millerlp/MusselGapeTracker_hardware/Pictures/Hall_effect_wiring_labeled.png

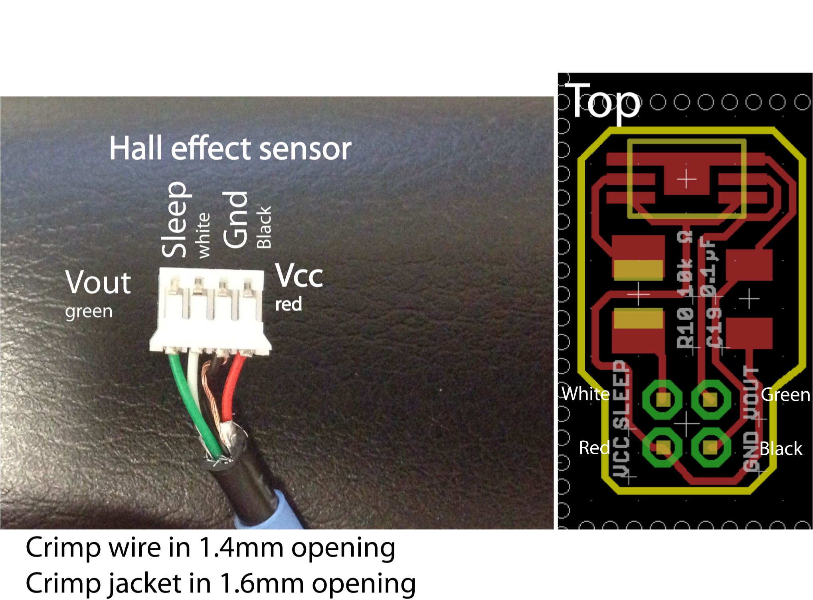
Pictures/Hall_effect_wiring_labeled.png
