millerlp/MusselGapeTracker_hardware/Pictures/RevA_2017-06-27 14.04.41.jpg

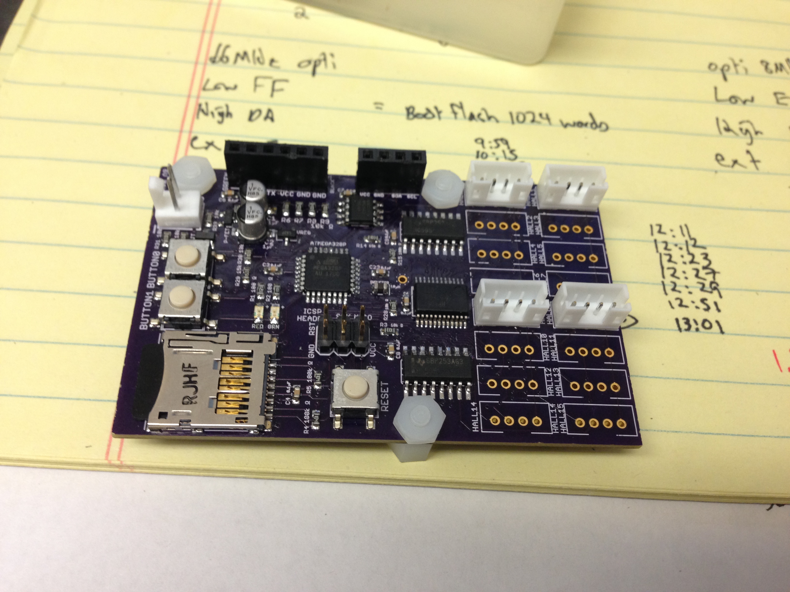
Pictures/RevA_2017-06-27 14.04.41.jpg
