millerlp/MusselGapeTracker_hardware/README.md

# MusselGapeTracker_hardware
 Mussel Gape Tracker circuit board designs
