millerlp/MusselGapeTracker_hardware/datasheets/atmega328_qtfp.jpg

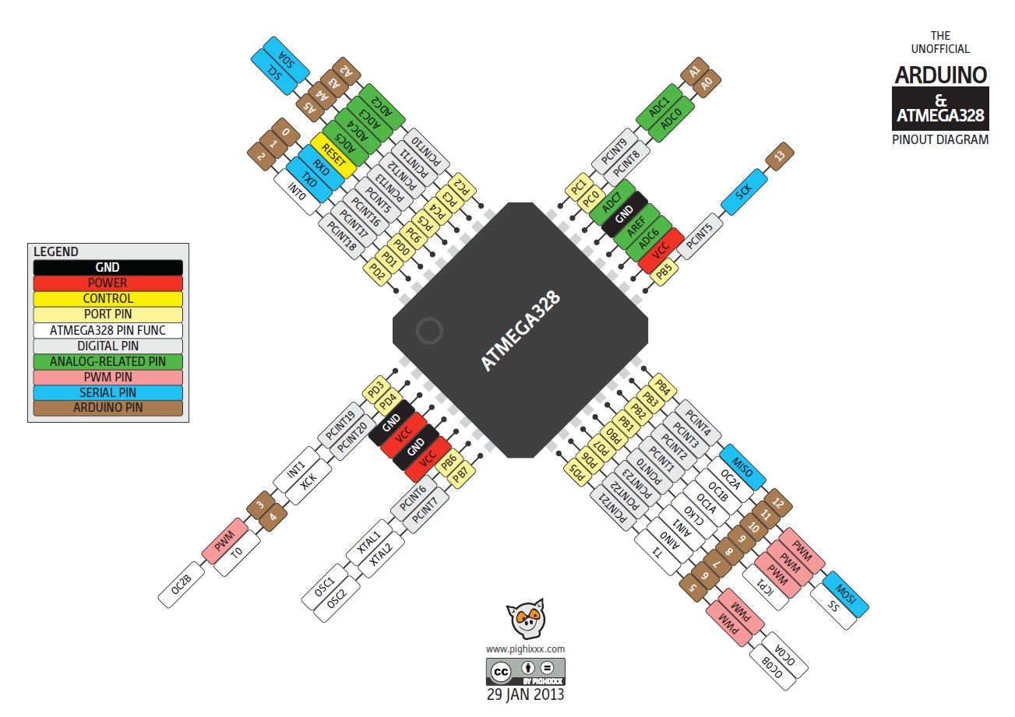
datasheets/atmega328_qtfp.jpg
