millerlp/MusselGapeTracker_hardware/datasheets/CD74HC4067_mux_pinout.png

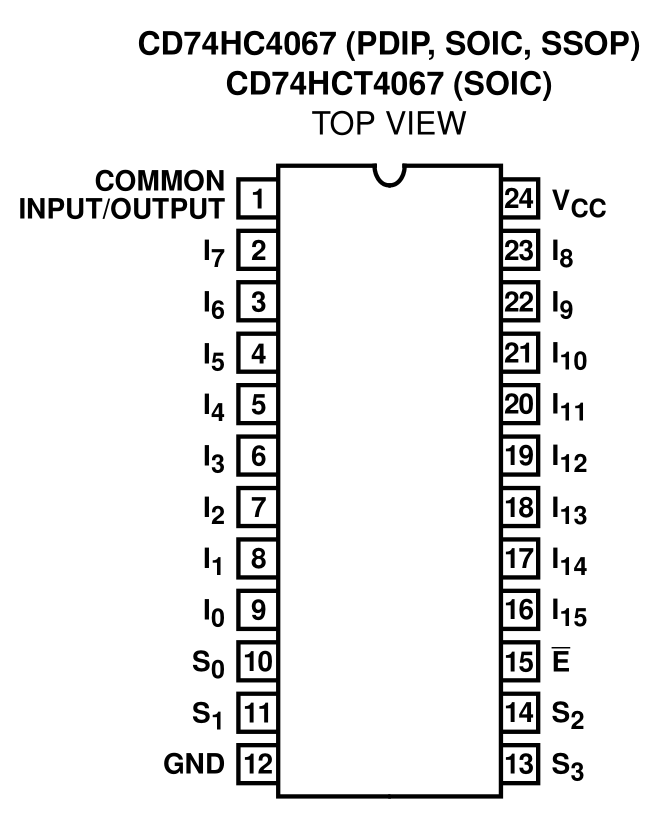
datasheets/CD74HC4067_mux_pinout.png
