millerlp/MusselGapeTracker_hardware/datasheets/Gammon_forum_74HC595_schematic.png

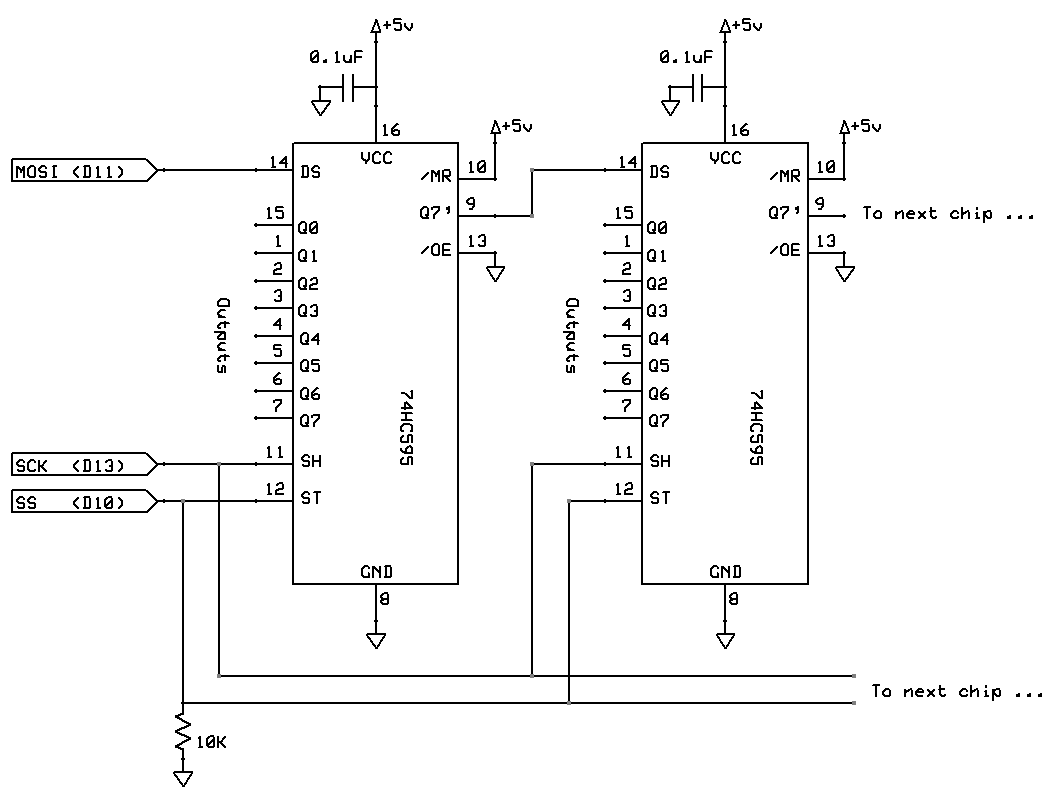
datasheets/Gammon_forum_74HC595_schematic.png
