millerlp/MusselGapeTracker_hardware/datasheets/SN74HC595D_pinout.png

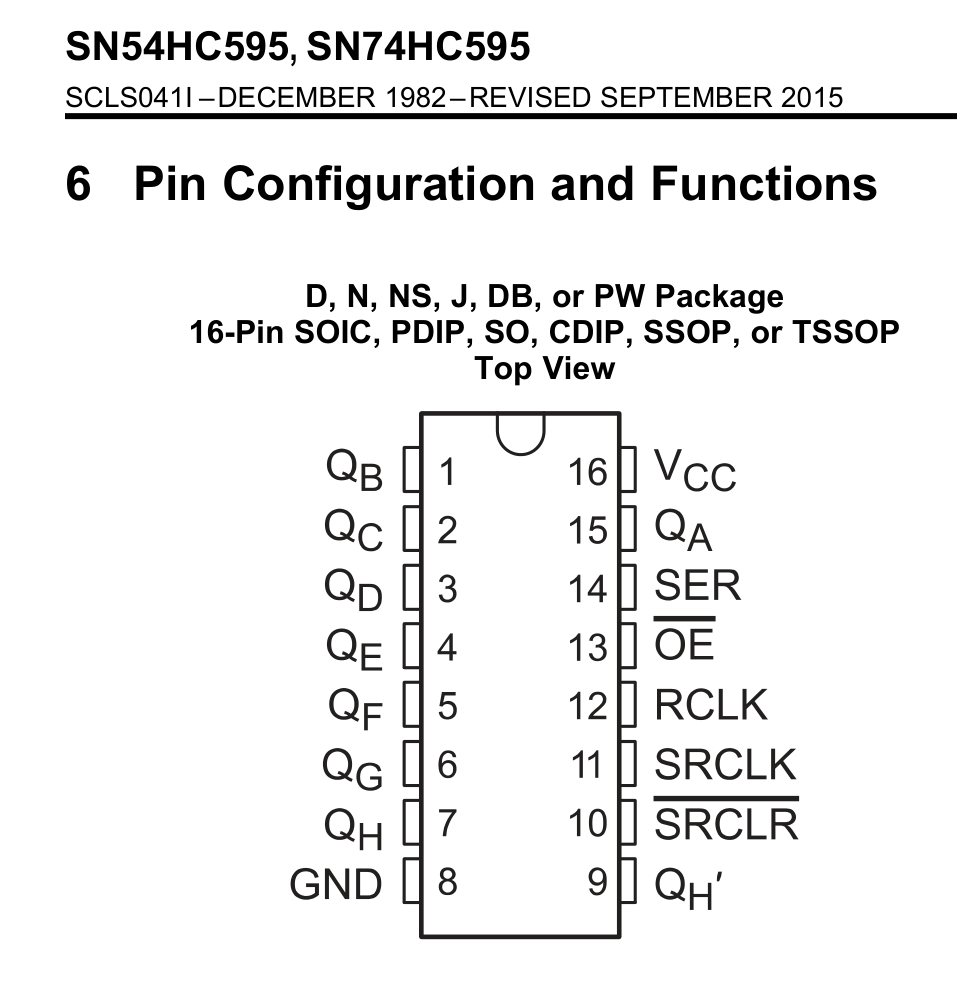
datasheets/SN74HC595D_pinout.png
