millerlp/MusselGapeTracker_hardware/Pictures/2019-05-07 10.28.47.jpg

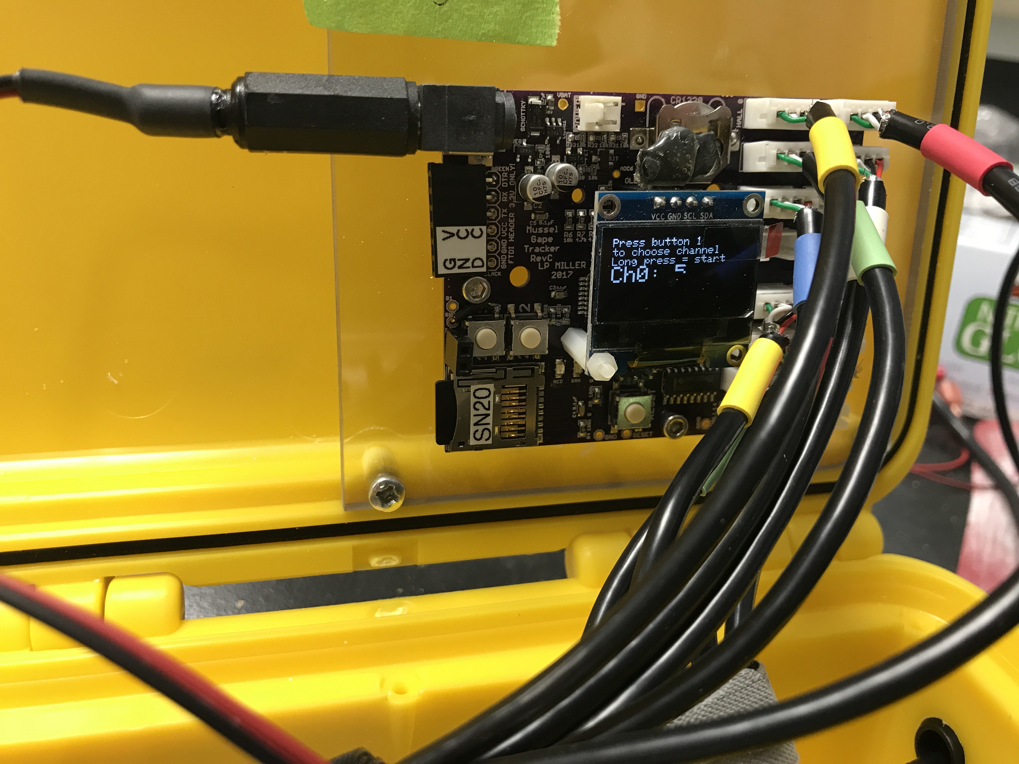
Pictures/2019-05-07 10.28.47.jpg
