millerlp/MusselGapeTracker_hardware/Pictures/2019-05-07 10.29.05.jpg

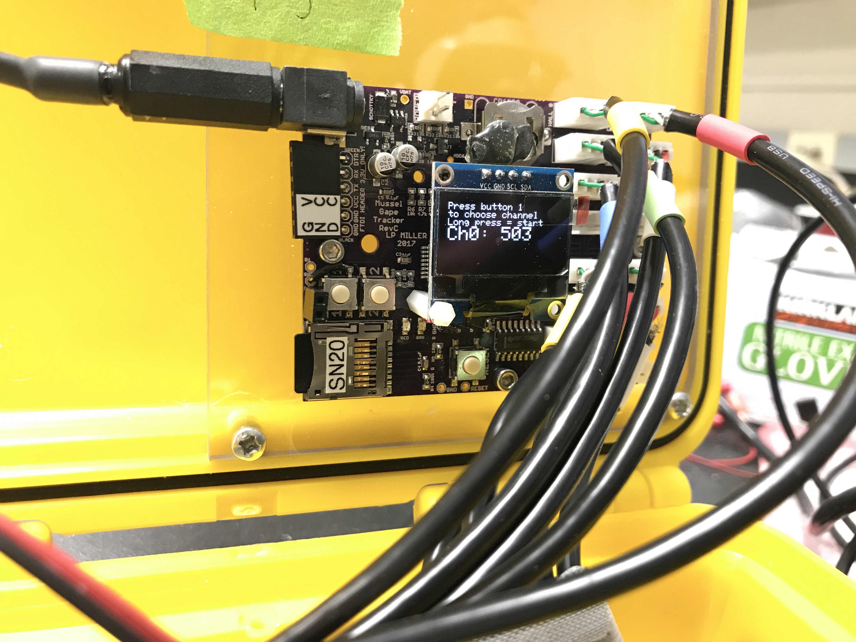
Pictures/2019-05-07 10.29.05.jpg
