millerlp/MusselGapeTracker_hardware/Pictures/Power_management_schematic.png

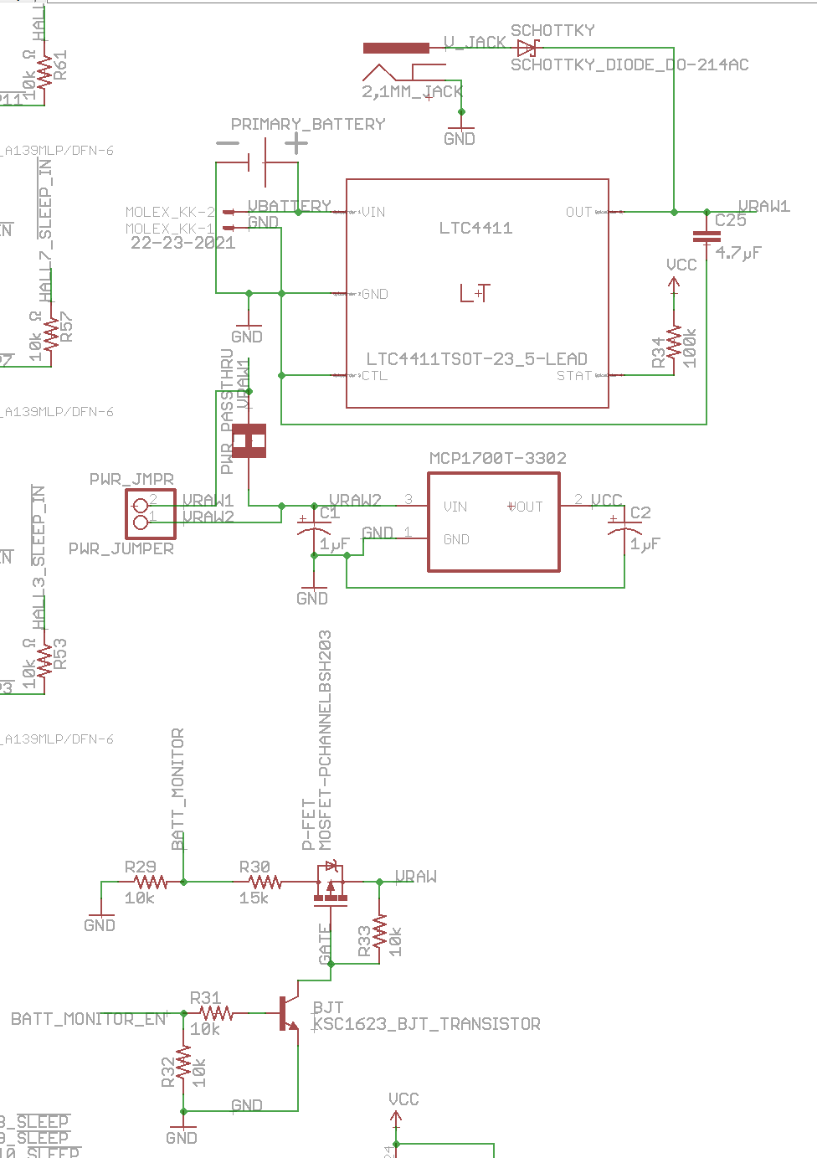
Pictures/Power_management_schematic.png
