millerlp/MusselGapeTracker_hardware/KiCad_files/Hall_effect_sensor_board_A139x/Hall_effect_sensor_board_A139x_parts_list.xlsx

Part Description | Manufacturer | Mfr. PN | Quantity (for 1 board) | Digikey PN | Digikey $ | Extended $ | Notes | Alt. Manu PN | Alt. Digikey PN
Hall effect sensor, Allegro A1395 | Allegro | A1395SEHLT-T | 1 | 620-1173-6-ND | $2.00 | $2.00 | Can also substitute A1393 or A1391 models, but these are less sensitive
Resistor, 0603 size 10k ohm 1/10Watt | Yageo | RC0603JR-0710KL | 1 | 311-10KGRCT-ND | $0.10 | $0.10 | Any 10k ohm, 1/10Watt, 5% tolerance, size 0603 resistor will work here | RMCF0603JT10K0 | RMCF0603JT10K0TR-ND
Capacitor, 0603 0.1µF 16V ceramic | KEMET | C0603C104K4RACTU | 1 | 399-1096-1-ND | $0.10 | $0.10 | Any 0.1uF 16V ceramic capacitor, size 0603 will work here | CC0603KRX7R7BB104 | 311-1088-2-ND
Additional parts - optional
Magnet 0.25"diam x 0.063" thick | Radial Magnet Inc | 8195 | 1 | 469-1005-ND | $0.23 | $0.23 | This is the typical magnet we use, but any decent magnet should work
4-conductor cable USB-2.0 28gauge 0.150" diameter | CNC Tech | 2725-2828-BL-01000-A | 1 | CN230-B-100-ND |  |  | 100 foot spool
JST 4-pin connector housing, female | JST Sales | PHR-4 | 1 | 455-1164-ND | $0.10 | $0.10
JST crimp-on female connector 24-30AWG | JST Sales | SPH-002T-P0.5S | 4 | 455-1127-1-ND | $0.10 | $0.40 | Always buy several extra
Heat shrink 1/4" ID x 4ft - moisture proof adhesive lined, semi-rigid | TE Connectivity | SCL-1/4-0-STK | 1 | SCL-1/4-0-STK-ND |  |  | Use approx 1.5" per sensor, can be either 1/4" or 0.3" inside diameter
Heat shrink 0.3" ID x 4ft - moisture proof adhesive lined, semi-rigid | TE Connectivity | SST-48-03/FR/97 | 1 | SST-48-03/FR/97-ND |  |  | Use approx 1.5" per sensor, can be either 1/4" or 0.3" inside diameter
