millerlp/MusselGapeTracker_hardware/deprecated/MusselGapeTracker_RevA_2_bom.txt

Partlist exported from D:/Dropbox/Eagle/Eagle_projects/MusselGapeTracker/MusselGapeTracker_RevA_2.sch at 5/26/2017 2:39 PM

Part           Value                             Device                            Package                           Description                                                                                                                      MF    MPN               OC_FARNELL OC_NEWARK PACKAGE PROD_ID     SUPPLIER  VALUE     
A139_HALL0     HALL_EFFECT_ALLEGRO_A139MLP/DFN-6 HALL_EFFECT_ALLEGRO_A139MLP/DFN-6 A139*_HALL_EFFECT                 Allegro A139* series Hall effect sensors                                                                                                                                                                              
A139_HALL1     HALL_EFFECT_ALLEGRO_A139MLP/DFN-6 HALL_EFFECT_ALLEGRO_A139MLP/DFN-6 A139*_HALL_EFFECT                 Allegro A139* series Hall effect sensors                                                                                                                                                                              
A139_HALL2     HALL_EFFECT_ALLEGRO_A139MLP/DFN-6 HALL_EFFECT_ALLEGRO_A139MLP/DFN-6 A139*_HALL_EFFECT                 Allegro A139* series Hall effect sensors                                                                                                                                                                              
A139_HALL3     HALL_EFFECT_ALLEGRO_A139MLP/DFN-6 HALL_EFFECT_ALLEGRO_A139MLP/DFN-6 A139*_HALL_EFFECT                 Allegro A139* series Hall effect sensors                                                                                                                                                                              
A139_HALL4     HALL_EFFECT_ALLEGRO_A139MLP/DFN-6 HALL_EFFECT_ALLEGRO_A139MLP/DFN-6 A139*_HALL_EFFECT                 Allegro A139* series Hall effect sensors                                                                                                                                                                              
A139_HALL5     HALL_EFFECT_ALLEGRO_A139MLP/DFN-6 HALL_EFFECT_ALLEGRO_A139MLP/DFN-6 A139*_HALL_EFFECT                 Allegro A139* series Hall effect sensors                                                                                                                                                                              
A139_HALL6     HALL_EFFECT_ALLEGRO_A139MLP/DFN-6 HALL_EFFECT_ALLEGRO_A139MLP/DFN-6 A139*_HALL_EFFECT                 Allegro A139* series Hall effect sensors                                                                                                                                                                              
A139_HALL7     HALL_EFFECT_ALLEGRO_A139MLP/DFN-6 HALL_EFFECT_ALLEGRO_A139MLP/DFN-6 A139*_HALL_EFFECT                 Allegro A139* series Hall effect sensors                                                                                                                                                                              
A139_HALL8     HALL_EFFECT_ALLEGRO_A139MLP/DFN-6 HALL_EFFECT_ALLEGRO_A139MLP/DFN-6 A139*_HALL_EFFECT                 Allegro A139* series Hall effect sensors                                                                                                                                                                              
A139_HALL9     HALL_EFFECT_ALLEGRO_A139MLP/DFN-6 HALL_EFFECT_ALLEGRO_A139MLP/DFN-6 A139*_HALL_EFFECT                 Allegro A139* series Hall effect sensors                                                                                                                                                                              
A139_HALL10    HALL_EFFECT_ALLEGRO_A139MLP/DFN-6 HALL_EFFECT_ALLEGRO_A139MLP/DFN-6 A139*_HALL_EFFECT                 Allegro A139* series Hall effect sensors                                                                                                                                                                              
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
C32            0.1µF                             CAP0603                           0603                              Capacitor                                                                                                                                                                                                             
C33            0.1µF                             CAP0603                           0603                              Capacitor                                                                                                                                                                                                             
CR1220_BATTERY CR1220_BATTERY_HOLDERSMD          CR1220_BATTERY_HOLDERSMD          CR1220_BATTERY_HOLDER_SMD         CR1220 Battery Holder                                                                                                                                                                                                 
DS3231M        DS3231MSOIC-8                     DS3231MSOIC-8                     DS3231M_SOIC8                     DS3231M real time clock                                                                                                                                                                                               
GROUND_CON     SOLDER_JUMPER_TRACESTANDARD       SOLDER_JUMPER_TRACESTANDARD       SJ_2S-TRACE                       Solder jumper with trace                                                                                                                                                                                              
HALL0          JST-4PINTH_STRAIGHT               JST-4PINTH_STRAIGHT               JST-PH-4-THM                      JST PH series male header pins                                                                                                                                                                                        
HALL0_HEADER   PINHD-2X21.5MM_SILK               PINHD-2X21.5MM_SILK               2X2_1.5MM                         2x2 header                                                                                                                                                                                                            
HALL1          JST-4PINTH_STRAIGHT               JST-4PINTH_STRAIGHT               JST-PH-4-THM                      JST PH series male header pins                                                                                                                                                                                        
HALL1_HEADER   PINHD-2X21.5MM_SILK               PINHD-2X21.5MM_SILK               2X2_1.5MM                         2x2 header                                                                                                                                                                                                            
HALL2          JST-4PINTH_STRAIGHT               JST-4PINTH_STRAIGHT               JST-PH-4-THM                      JST PH series male header pins                                                                                                                                                                                        
HALL2_HEADER   PINHD-2X21.5MM_SILK               PINHD-2X21.5MM_SILK               2X2_1.5MM                         2x2 header                                                                                                                                                                                                            
HALL3          JST-4PINTH_STRAIGHT               JST-4PINTH_STRAIGHT               JST-PH-4-THM                      JST PH series male header pins                                                                                                                                                                                        
HALL3_HEADER   PINHD-2X21.5MM_SILK               PINHD-2X21.5MM_SILK               2X2_1.5MM                         2x2 header                                                                                                                                                                                                            
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
HALL15_HEADER  PINHD-2X21.5MM_SILK               PINHD-2X21.5MM_SILK               2X2_1.5MM                         2x2 header                                                                                                                                                                                                            
I2C_HEADER     PINHD-1X4BIG_LOCK                 PINHD-1X4BIG_LOCK                 1X04_BIGLOCK                      1x4 header, multiple pins spacings                                                                                                                                                                                    
INDUCTOR       10µH                              INDUCTOR0805_TY                   I_0805                            Inductor                                                                                                                                                                                                              
J1             AVR_SPI_PRG_6PTH                  AVR_SPI_PRG_6PTH                  2X3                               AVR ISP 6 Pin                                                                                                                                                                                                         
JP1            FTDI_HEADER                       PINHD-1X6LOCK                     1X06-BIGLOCK                      PIN HEADER                                                                                                                                                                                                            
LED1           RED_LED                           LED0805                           CHIPLED_0805                      LEDs                                                                                                                                                                                                                  
LED2           GREEN_LED                         LED0805                           CHIPLED_0805                      LEDs                                                                                                                                                                                                                  
MCP1700T-3302  MCP1700T-3302E/TT                 MCP1700T-3302E/TT                 SOT95P237X112-3N                  Low Quiescent Current LDO 3.3V                                                                                                         MCP1700T-3302E/TT 1296592    88H9817   SOT23-3             Microchip           
P-FET          MOSFET-PCHANNELBSH203             MOSFET-PCHANNELBSH203             SOT23-3                           Generic PMOSFET                                                                                                                                                                       TRANS-08285                     
R1             100 O                             RESISTOR_SMDR0603                 R0603                             RESISTOR, American symbol                                                                                                                                                                                             
R2             100 O                             RESISTOR_SMDR0603                 R0603                             RESISTOR, American symbol                                                                                                                                                                                             
R3             10k O                             RESISTOR_SMDR0603                 R0603                             RESISTOR, American symbol                                                                                                                                                                                             
R4             100k O                            RESISTOR_SMDR0603                 R0603                             RESISTOR, American symbol                                                                                                                                                                                             
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
STANDOFF1      STAND-OFF                         STAND-OFF                         STAND-OFF                         #4 Stand Off                                                                                                                                                                                                          
STANDOFF2      STAND-OFF                         STAND-OFF                         STAND-OFF                         #4 Stand Off                                                                                                                                                                                                          
STANDOFF3      STAND-OFF                         STAND-OFF                         STAND-OFF                         #4 Stand Off                                                                                                                                                                                                          
U$1            MICROSD_MOLEX_REVERSECURRENT      MICROSD_MOLEX_REVERSECURRENT      MICROSD_SOCKET_MOLEX_REVERSEMOUNT Molex micro SD connector, push-push spring loaded, "reverse" mount                                                                                                                                                    
U$2            74HC4067SM96                      74HC4067SM96                      SSOP24                            74HC4067 16-channel multiplexer                                                                                                                                                                                       
U$17           PINHD-1X1SMALL                    PINHD-1X1SMALL                    1X01_SMALL                        Just a single pin header, useful for making test point or stand-alone header hole for normal 0.1" pitch through-hole header pins                                                                                      
U1             ATMEGA328P                        ATMEGA328_SMT                     TQFP32-08                         32-Pin Atmega328                                                                                                                                                                                            ATMEGA328P
X1             22-23-2021                        22-23-2021                        22-23-2021                        Molex KK series                                                                                                                  MOLEX 22-23-2021        1462926    25C3832
