millerlp/MusselGapeTracker_hardware/deprecated/MusselGapeTracker_schematic_RevA.pdf

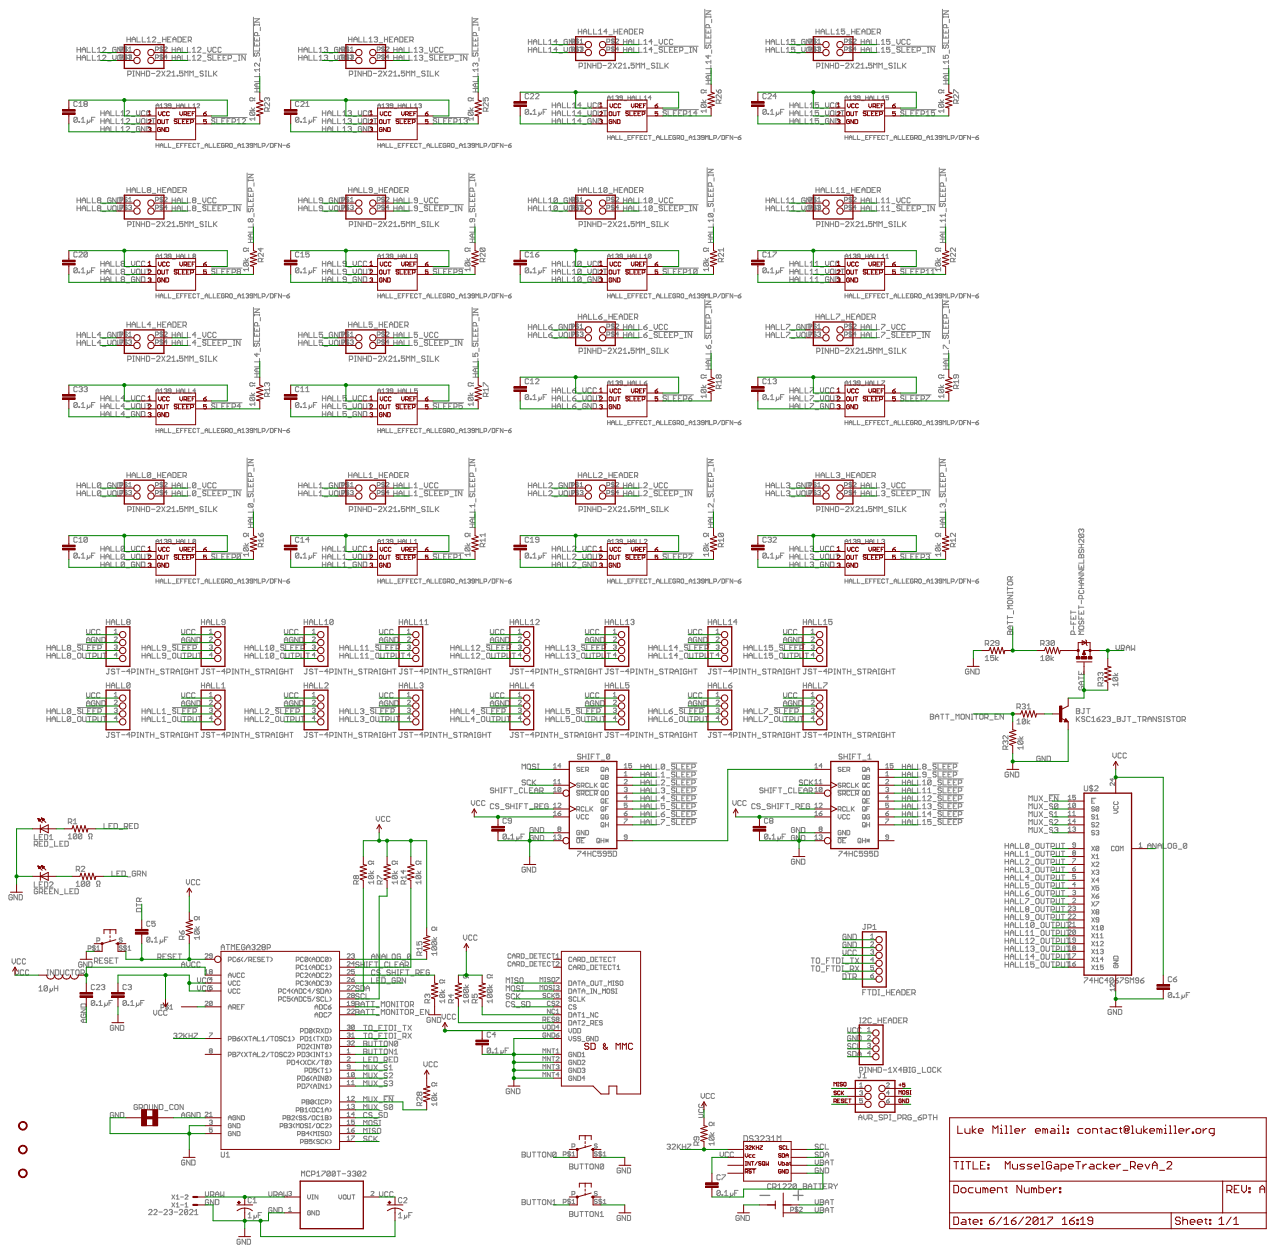
[picture p10: page 1]
