millerlp/MusselGapeTracker_hardware/deprecated/KiCad_deprecated/MusselGapeTracker_RevF/Pictures/MusselGapeTracker_RevF Schematic.pdf

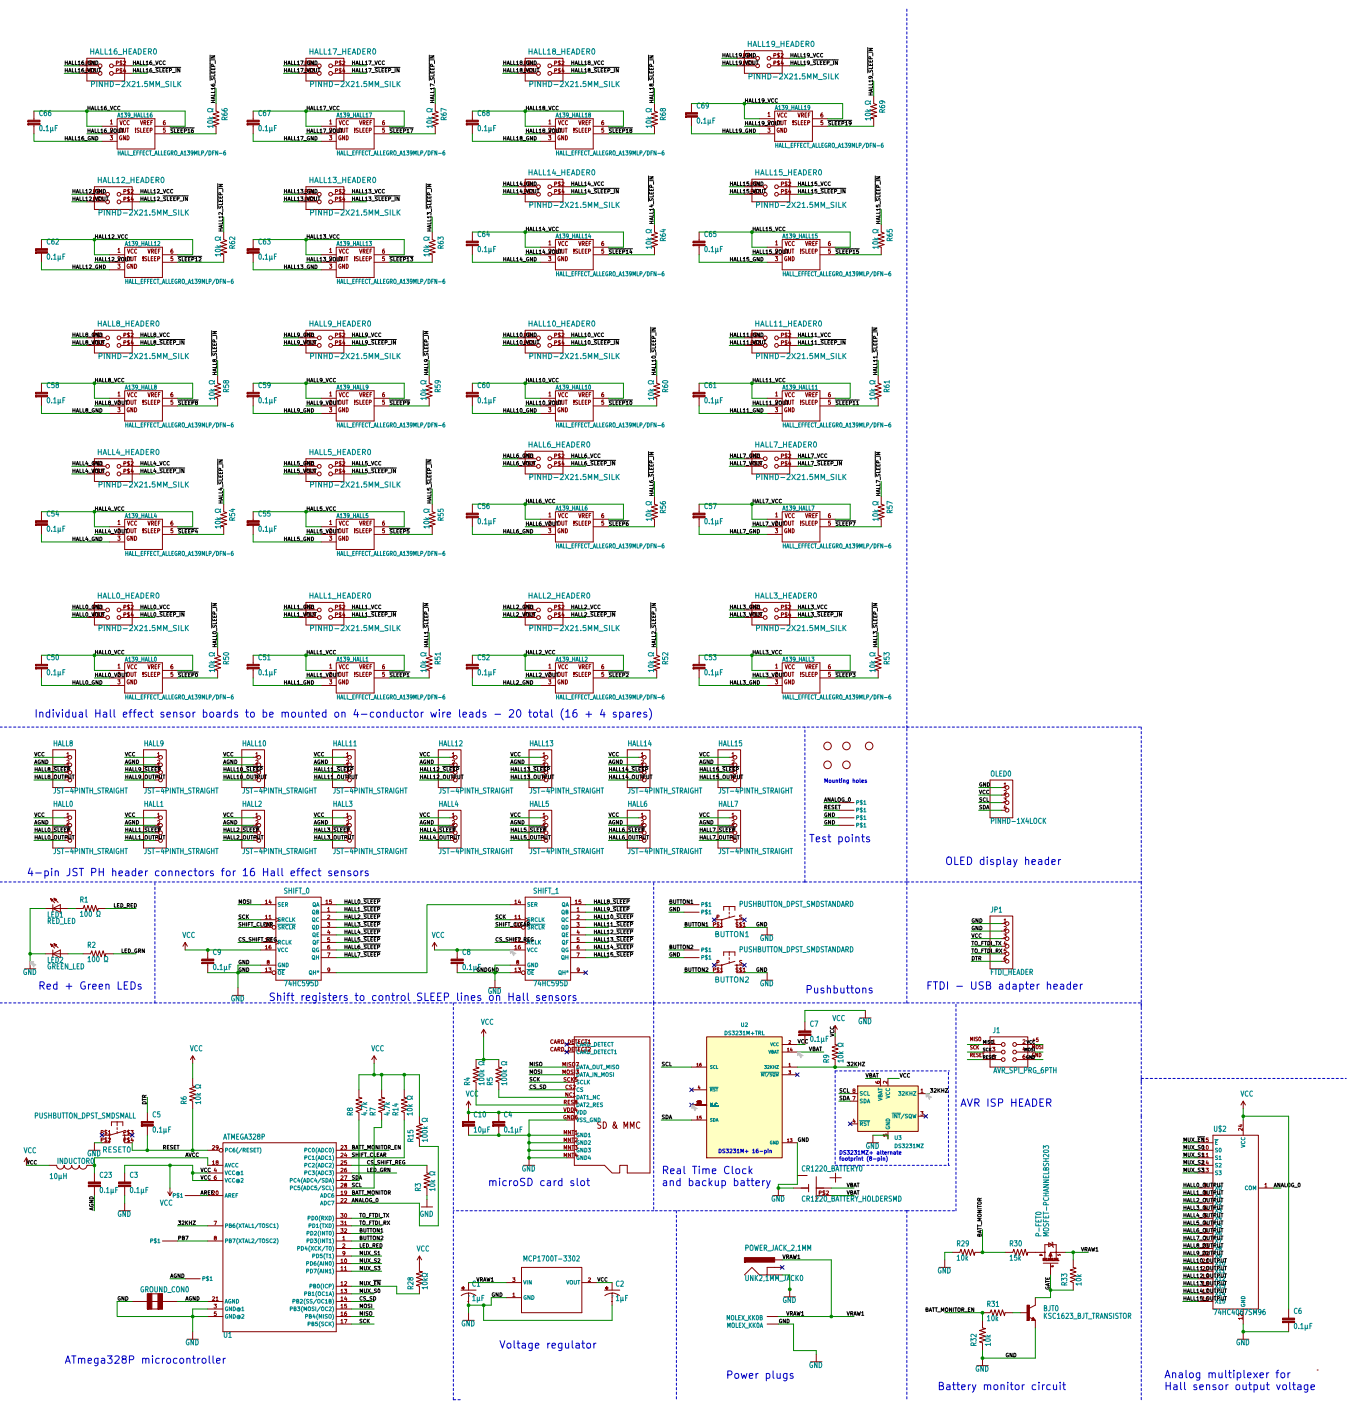
[picture p11: page 1]
