millerlp/MusselGapeTracker_hardware/deprecated/Eagle_files/MusselGapeTracker_RevC.pdf

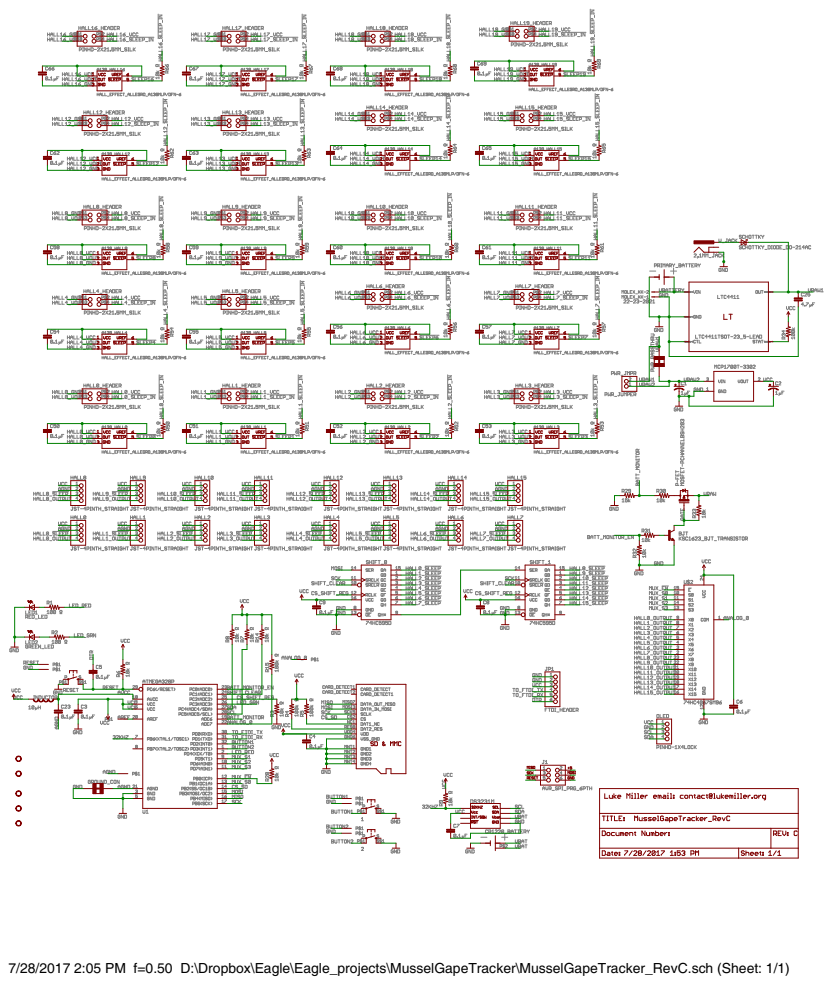
[picture p12: page 1]

7/28/2017 2:05 PM f=0.50 D:\Dropbox\Eagle\Eagle_projects\MusselGapeTracker\MusselGapeTracker_RevC.sch (Sheet: 1/1)
