millerlp/MusselGapeTracker_hardware/deprecated/Eagle_files/MusselGapeTracker_RevE.pdf

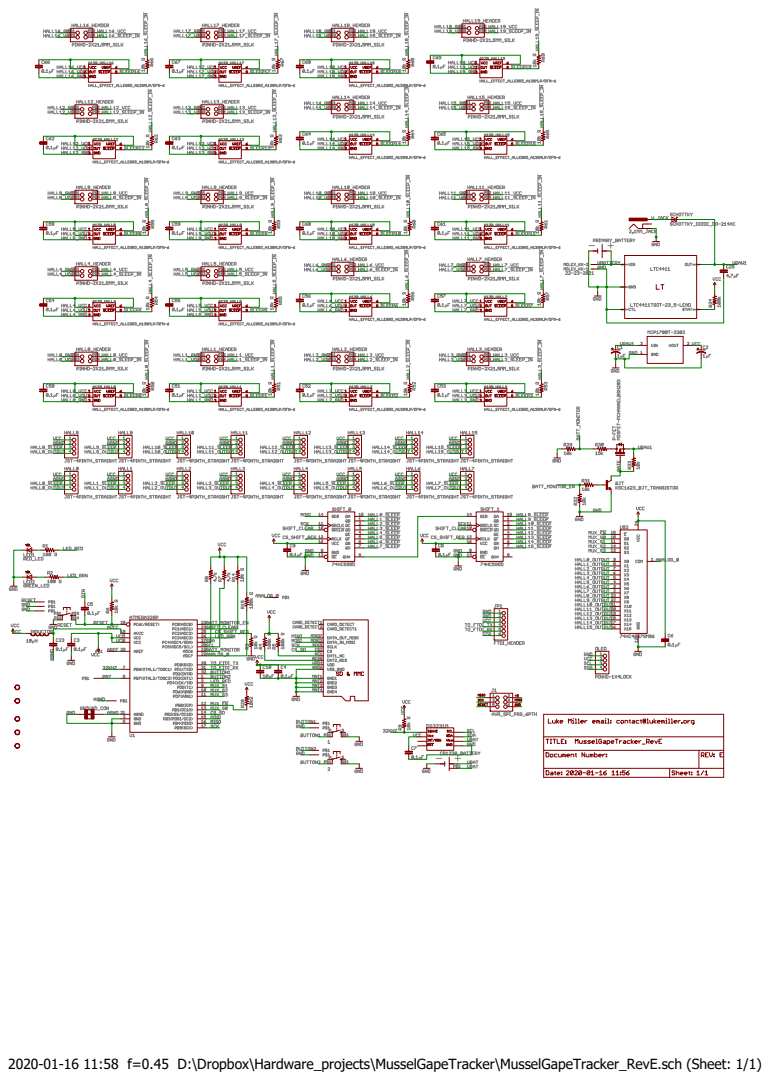
[picture p13: page 1]

2020-01-16 11:58 f=0.45 D:\Dropbox\Hardware_projects\MusselGapeTracker\MusselGapeTracker_RevE.sch (Sheet: 1/1)
