millerlp/MusselGapeTracker_hardware/(commit log)

2023-12-08 Catching these up
    [MusselGapeTracker_RevH.kicad_sch, MusselGapeTracker_RevH_parts_list.xlsx]
2025-03-18 Parts list Excel files
    [Hall_effect_sensor_board_A139x_parts_list.xlsx, MusselGapeTracker_RevH_parts_list.xlsx]
